ElcRcp/dsPIC33CH512MP508-Dev.-Board/Schematics/Schematics.PDF

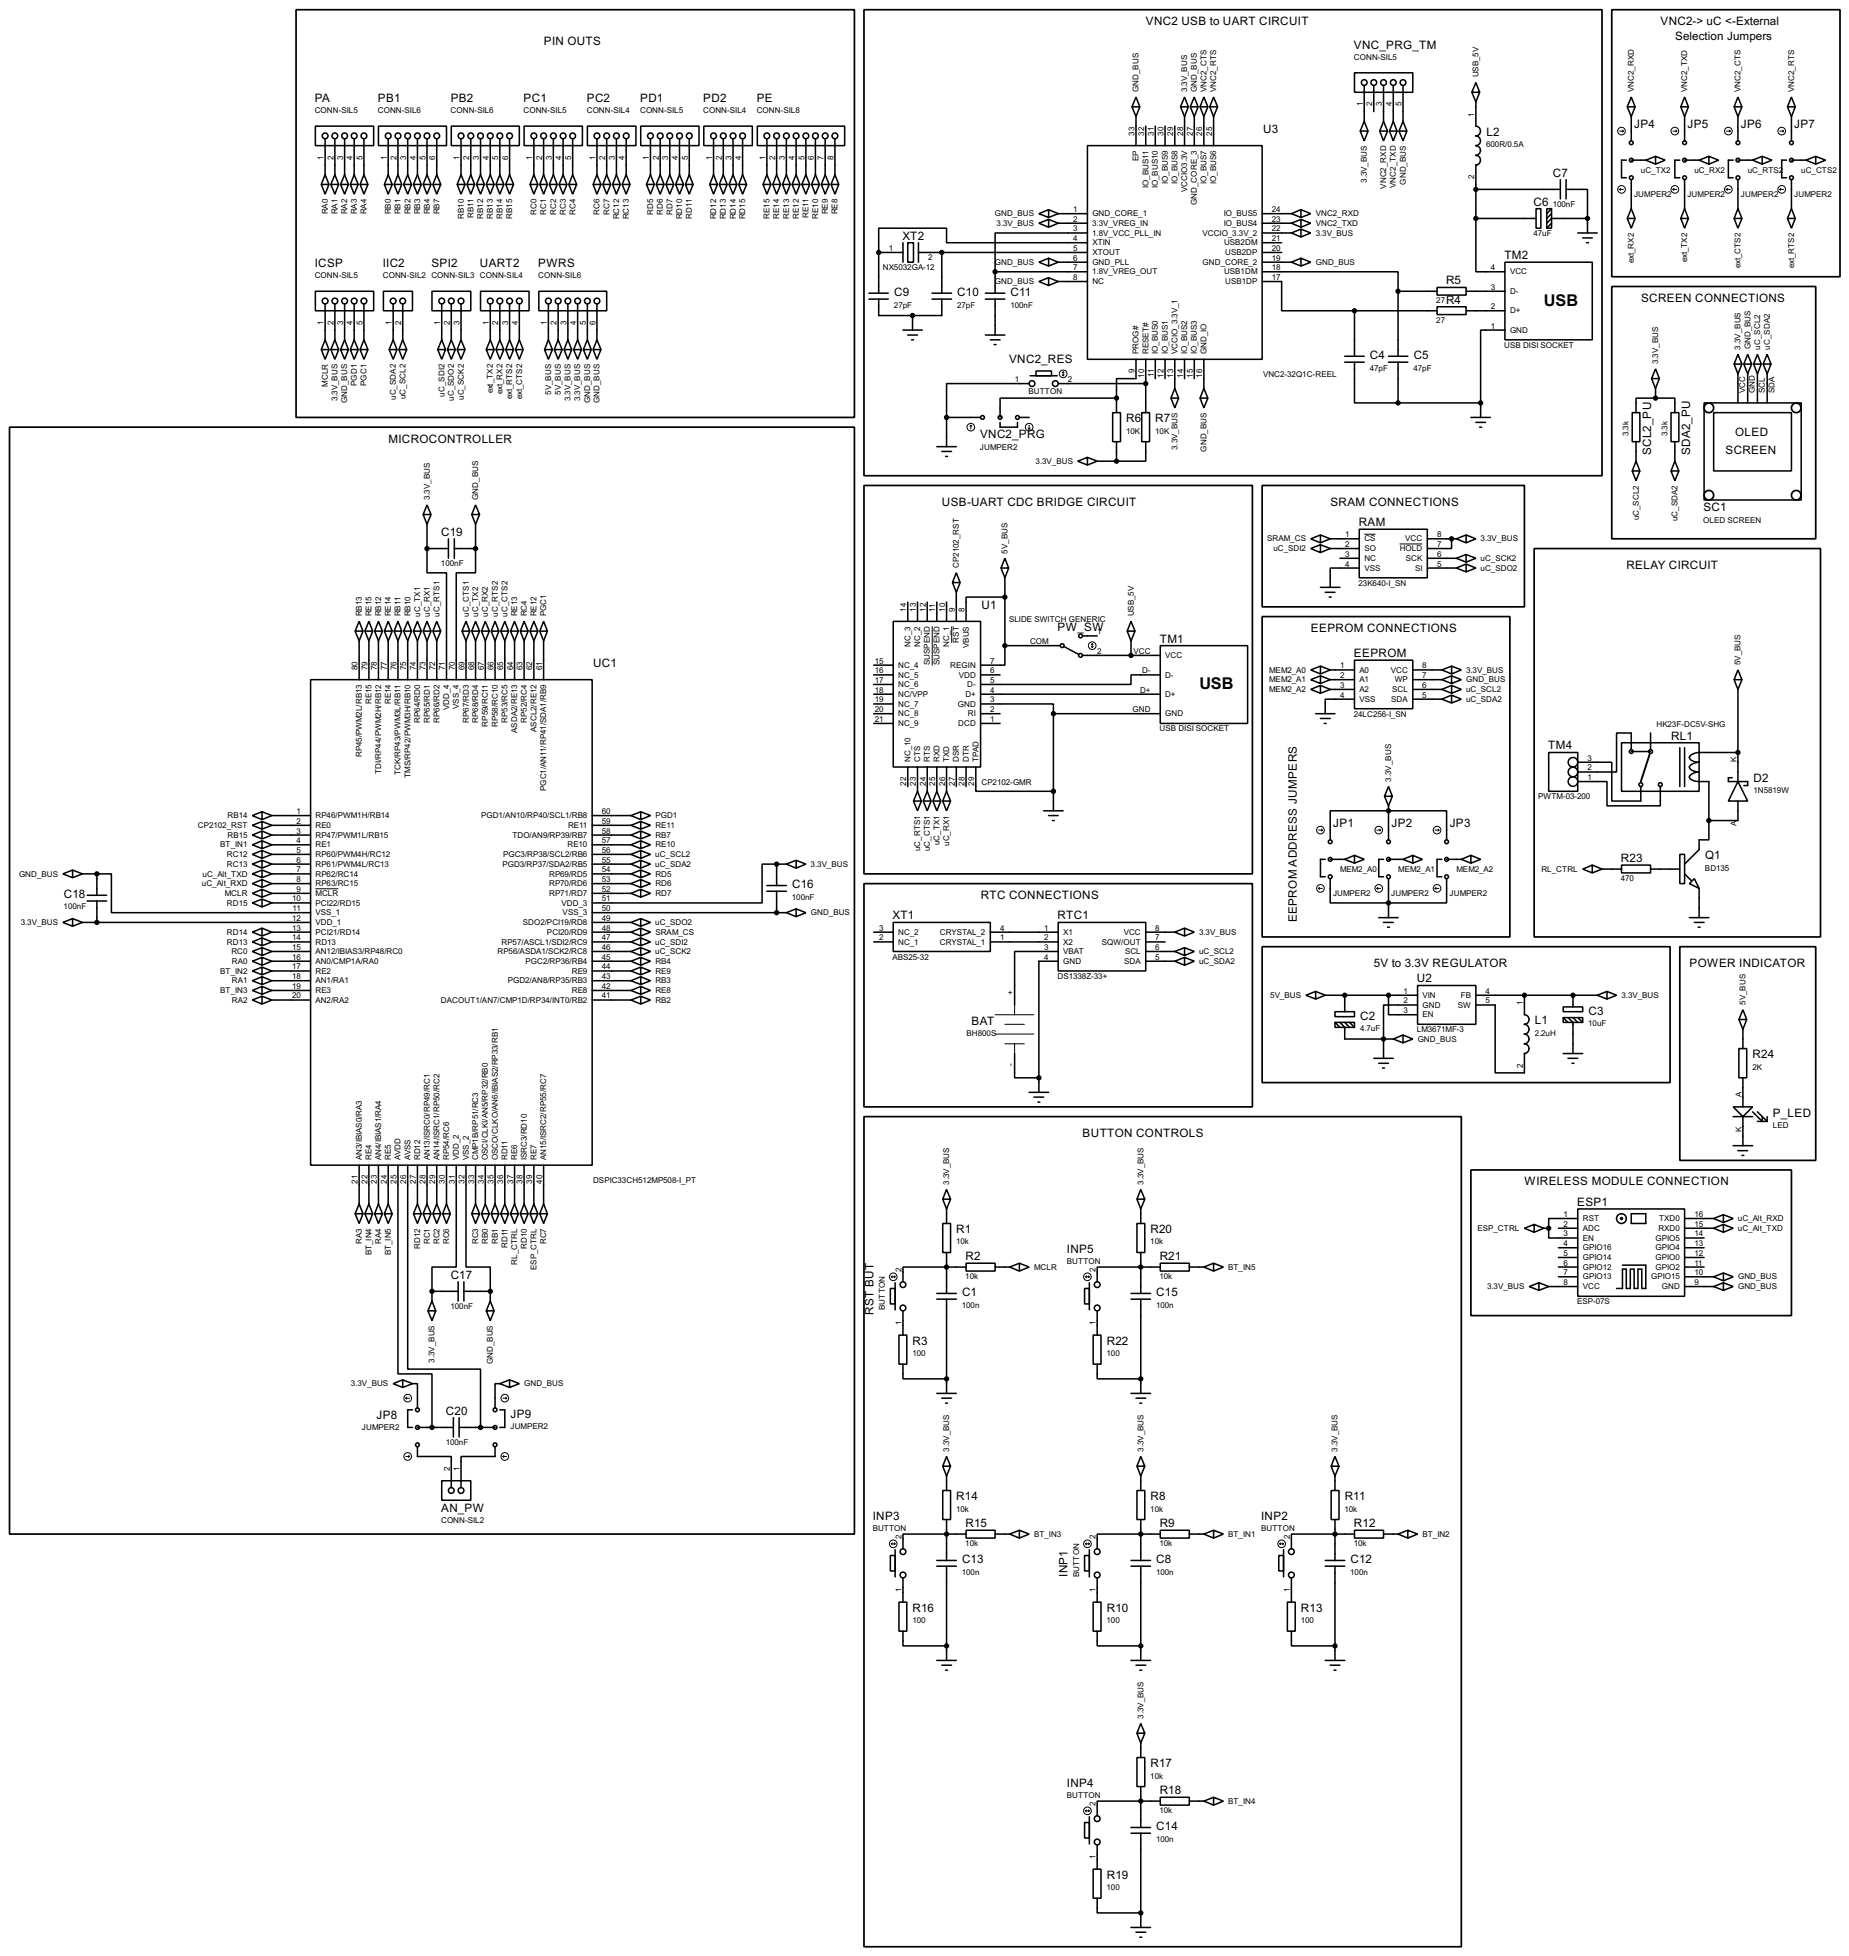
[picture p1: page 1]

VNC2 USB to UART CIRCUIT

USB DISI SOCKET DCD

55 RP69/RD5 54 RP70/RD6 53 RP71/RD7 52 VDD_3 | RD5 RD6 RD7

JUMPER2 | JUMPER2
