ElcRcp/dsPIC33CH512MP508-Dev.-Board/Tech Docs/Vinculum_II_VDRIVE3 Schematic Prints.pdf

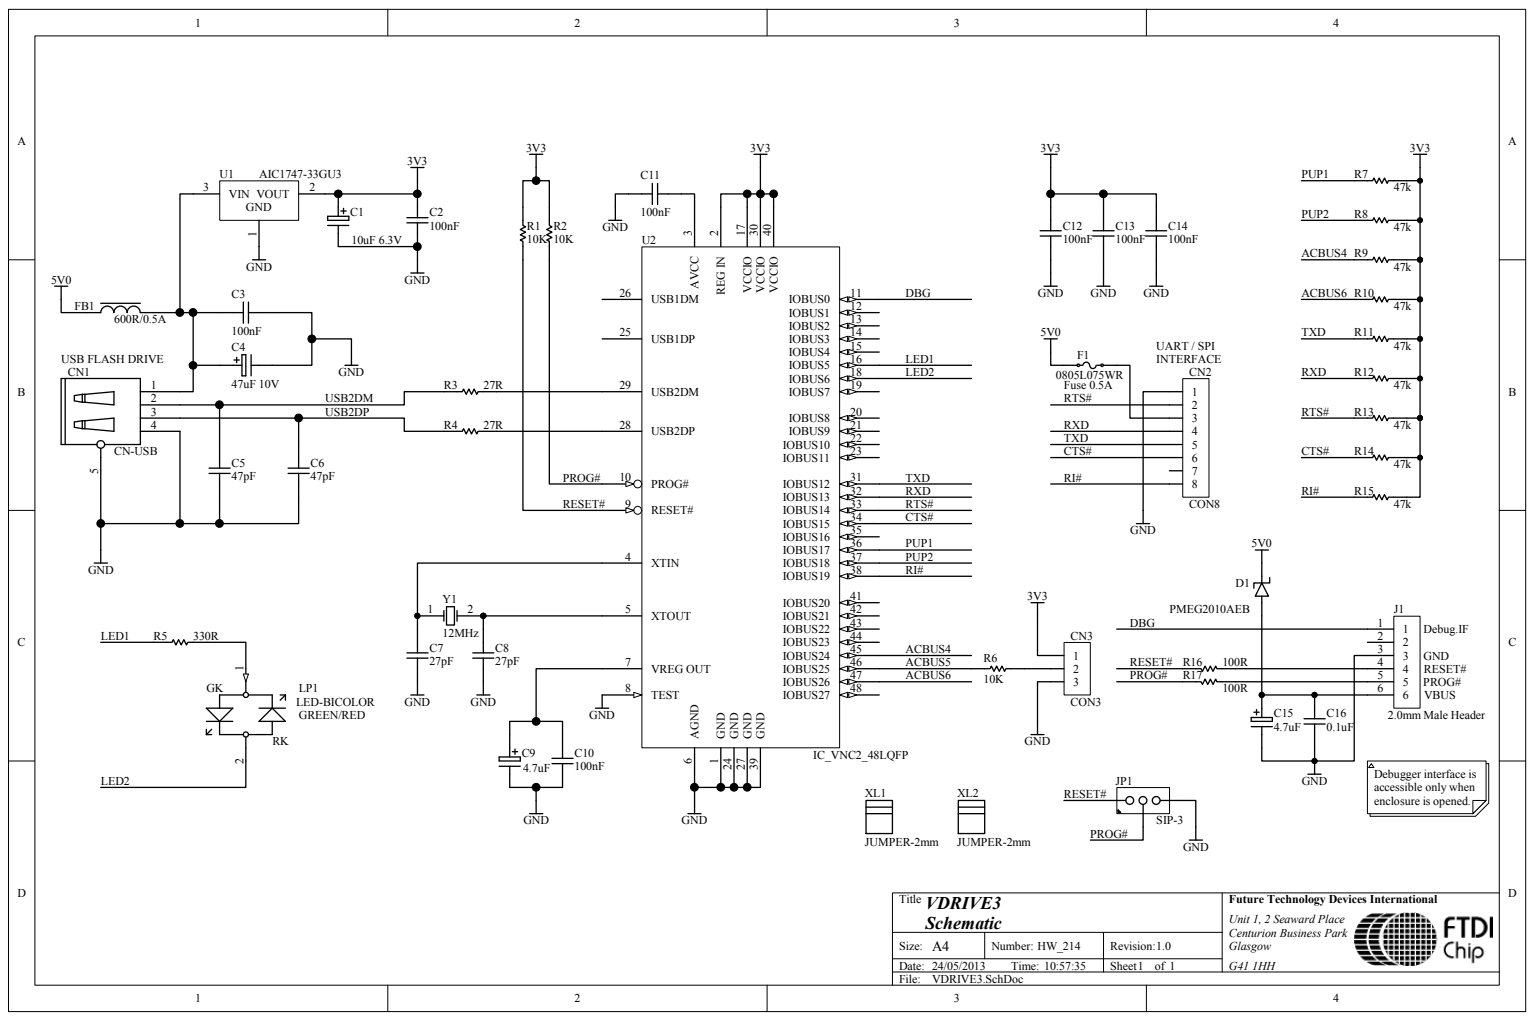
[picture p2: page 1]

Future Technology Devices International
Unit 1, 2 Seaward Place
Centurion Business Park
Glasgow
