ElcRcp/dsPIC33CH512MP508-Dev.-Board/Schematics/BOTTOM_PCB.PDF

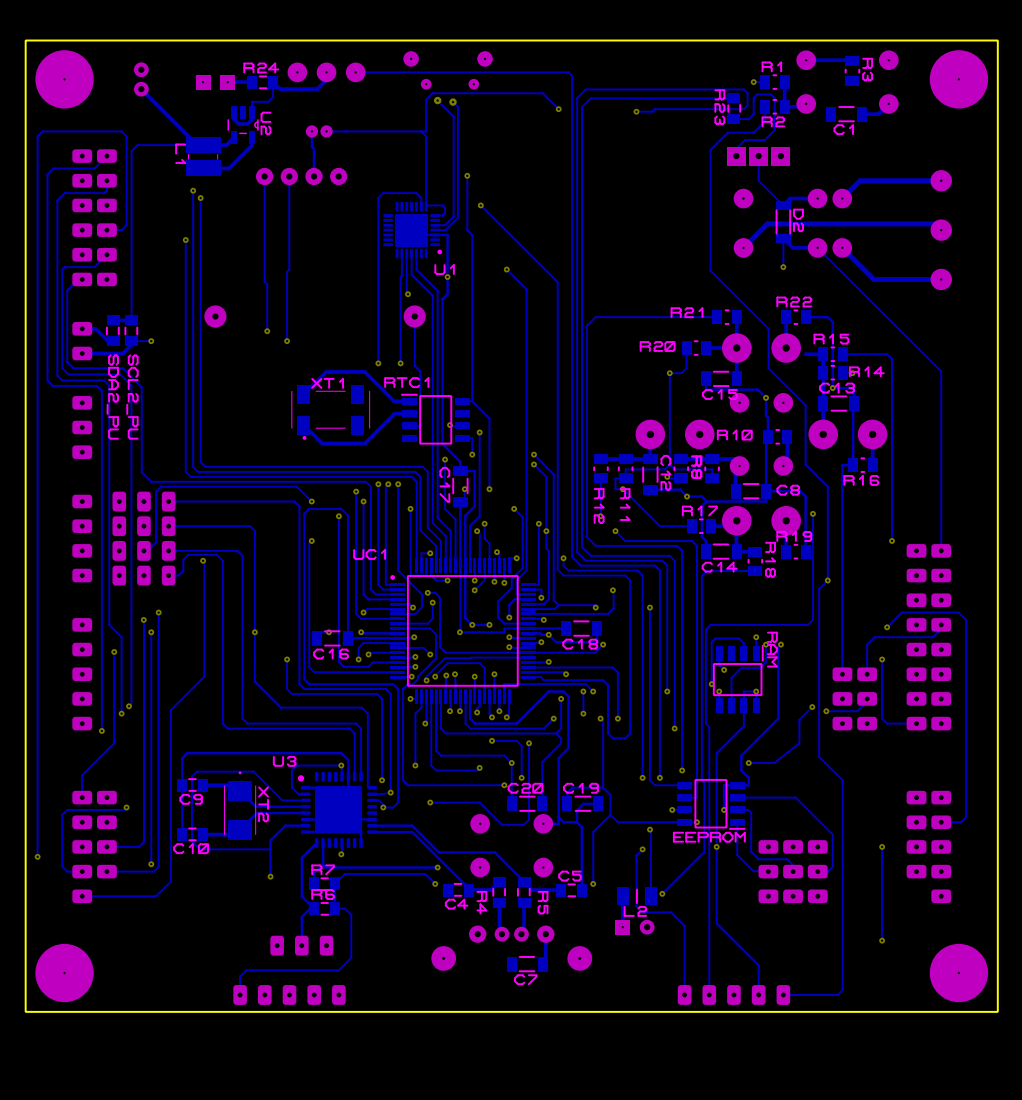
[picture p3: page 1]
