ElcRcp/dsPIC33CH512MP508-Dev.-Board/Schematics/TOP_PCB.PDF

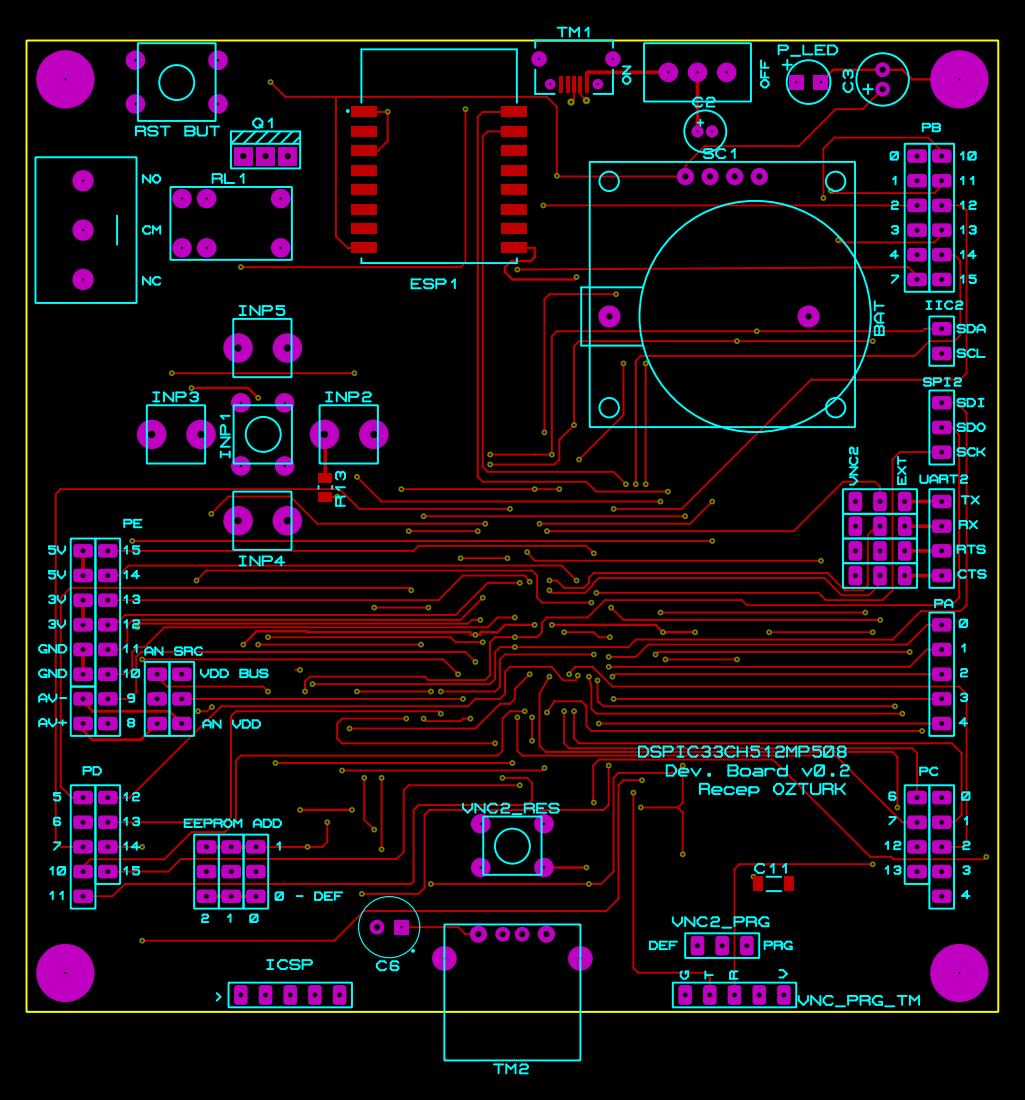
[picture p4: page 1]
