ElcRcp/dsPIC33CH512MP508-Dev.-Board/(list of files, drawings)

Other design files:
Schematics/dsPIC33CH512MP508_Dev_Board_v01.pdsprj
Schematics/dsPIC33CH512MP508_Dev_Board_v02.pdsprj
