ElcRcp/dsPIC33CH512MP508-Dev.-Board/(commit log)

2020-02-10 Old files uploaded
    old files uploaded
    [dsPIC33CH512MP508_Dev_Board_v01.pdsprj, dsPIC33CH512MP508_Dev_Board_v02.pdsprj]
2020-02-10 office branch
    office branch
    [dsPIC33CH512MP508_Dev_Board_v01.pdsprj, dsPIC33CH512MP508_Dev_Board_v02.pdsprj]
2020-02-10 pcb and schematics added
2020-02-10 pin defines are made, #use commands corrected, tris values defined.
    [eeprom24lc256.h, sram23k640.h]
2020-02-16 Rtos Update
    Rtos functions added, input button contros are tied to Rtos, screen update tied to Rtos, RTC codes finished and date-time values showed on screen. Code improvements applied. Still can't run IOC again, Still can't make UART run.
2020-03-10 uart2 run checked
2020-05-07 Screen menu update
    Most of problems solved, a working screen menu being developed.
    [main.c, main.h, rtos_tasks.h]
2020-05-16 ext_eeprom Code Update
    Ext eeprom write-read implemented and tried, faced with many read-write problems but still note sure why, looked like compiler problem, eeprom cells might physically damaged too, not sure.
    Dev name, description and version written on different address blocks.
    [eeprom24lc256.h, main.c, main.h, rtos_tasks.h]
2020-05-17 ESP activated
    Uart1 connected redirected to ESP, options added to screen menu for ESP, interrupt routines added for uart channels.
2020-07-01 USB-UART Bridge Repaired
    a new cp1202 IC soldered to board, PIC UART1 to USB-CDC bridge is working now
